hello/morpheus-board-pill/README.md

morpheus-board-pill
===================

sleep motion senser

Altium source for schematic / layout
