hello/morpheus-board-pill/pill.pvt/Morpheus_pill_MP_release_011215.PDF

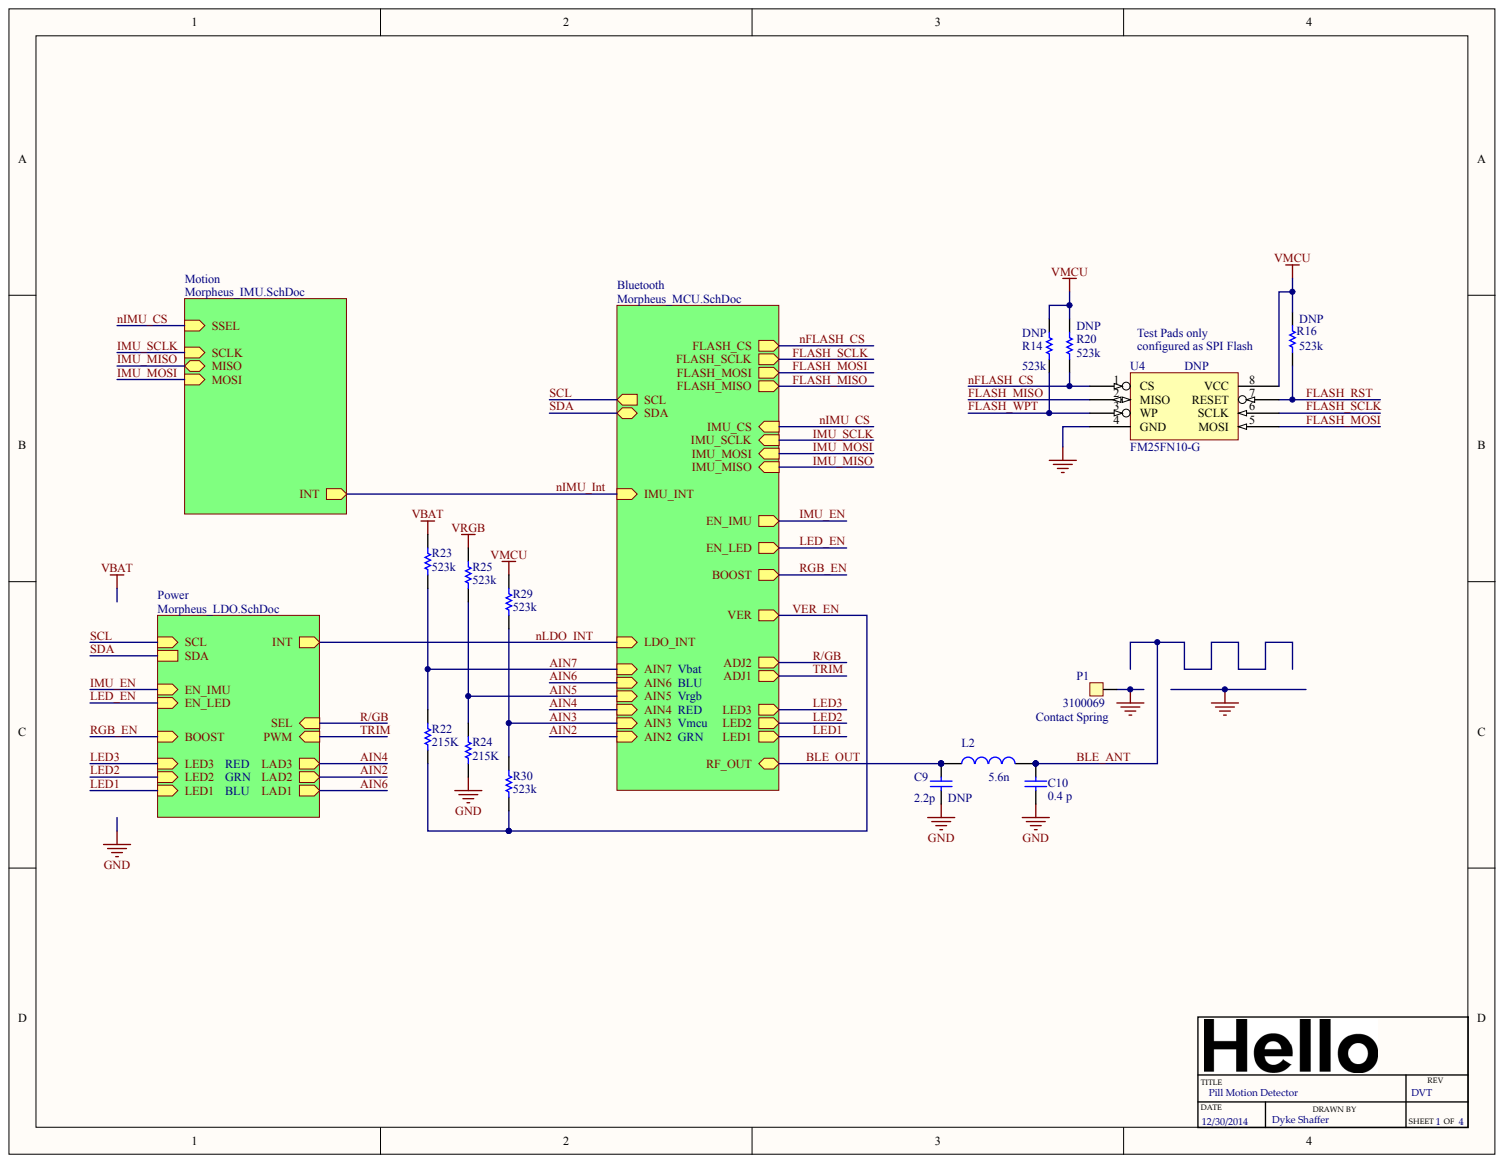
[picture p1: page 1]

configured as SPI Flash

AIN7

215K | | AIN6 AIN5

R24 | AIN4 AIN3

TITLE Pill Motion Detector | REV DVT

D ATE | DRAWN BY Dyke Shaffer | S HEET 1 OF

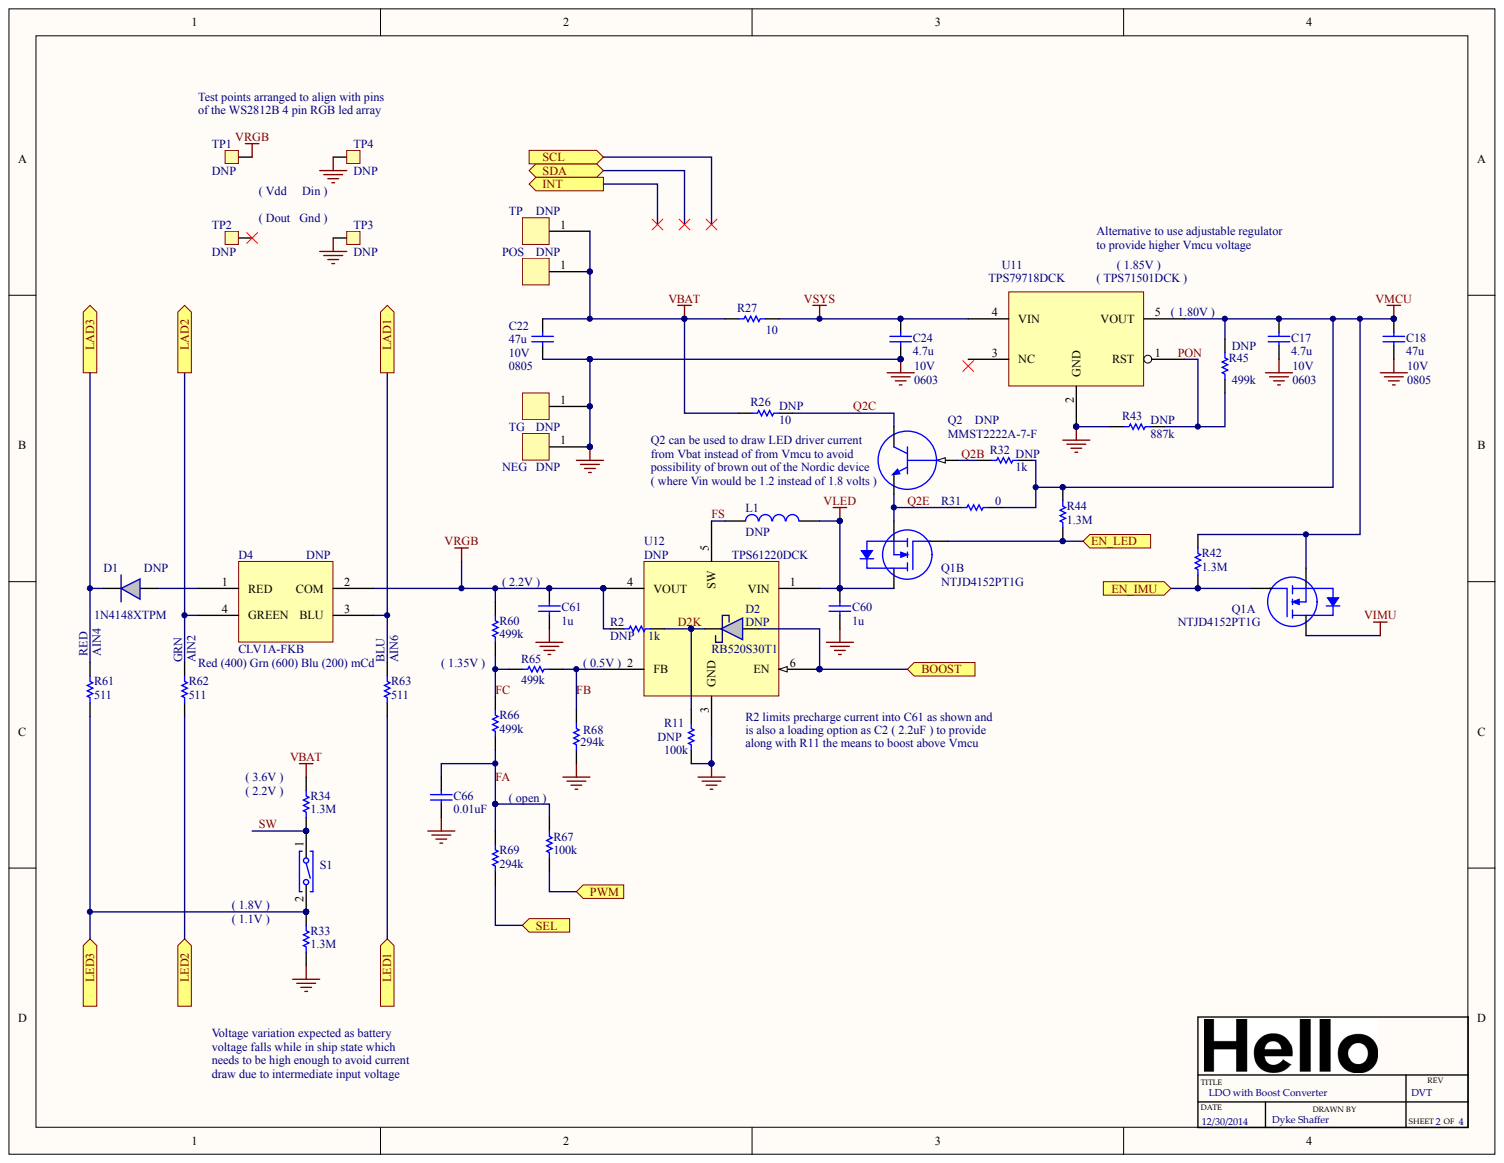
[picture p2: page 2]

Test points arranged to align with pins
of the WS2812B 4 pin RGB led array

Alternative to use adjustable regulator
to provide higher Vmcu voltage

VOUT RST | 1 NC

VIN

Q2 can be used to draw LED driver current
from Vbat instead of from Vmcu to avoid
possibility of brown out of the Nordic device
( where

Vin would be 1.2 instead of 1.8 volts )

R2 limits precharge current into C61 as shown and
is also a loading option as C2 ( 2.2uF ) to provide
along with R11 the means to boost above Vmcu

Voltage variation expected as battery
voltage falls while in ship state which
needs to be high enough to avoid current
draw due to intermediate input voltage

LDO with Boost Con verter

D ATE | DRAWN BY Dyke Shaffer | S HEET 2 OF

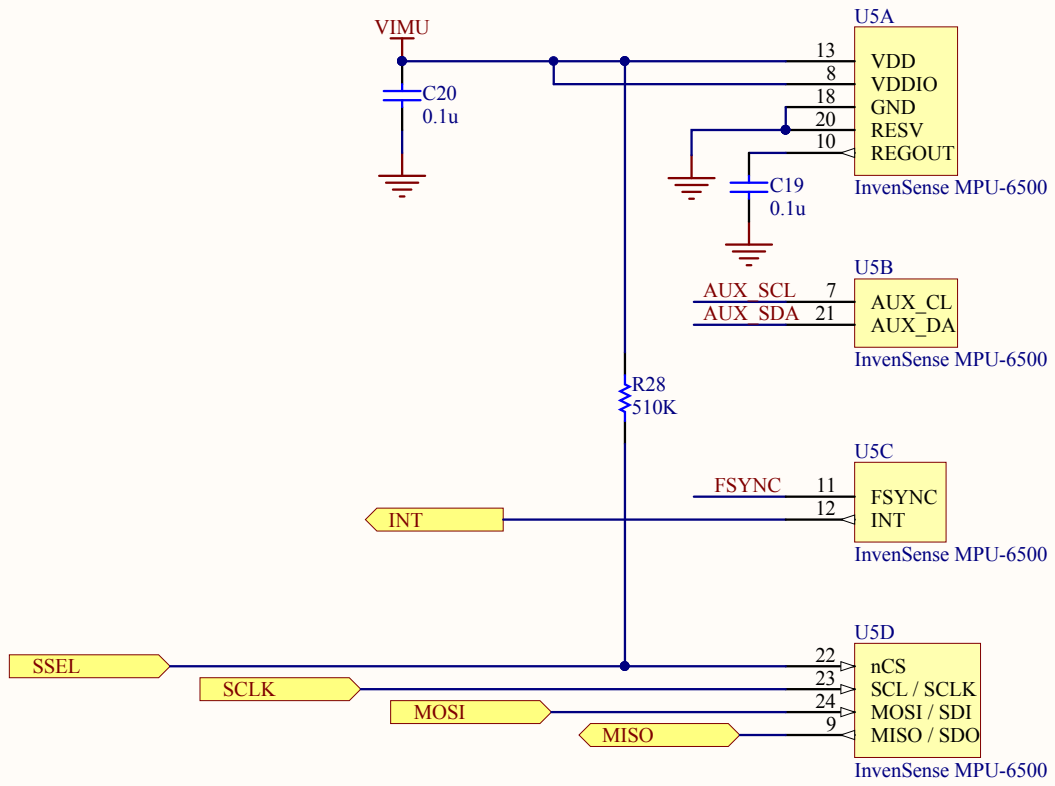
[picture p3: page 3]

IMU Motion Detecter

DATE | DRAWN BY * | SHEET 3 OF 4

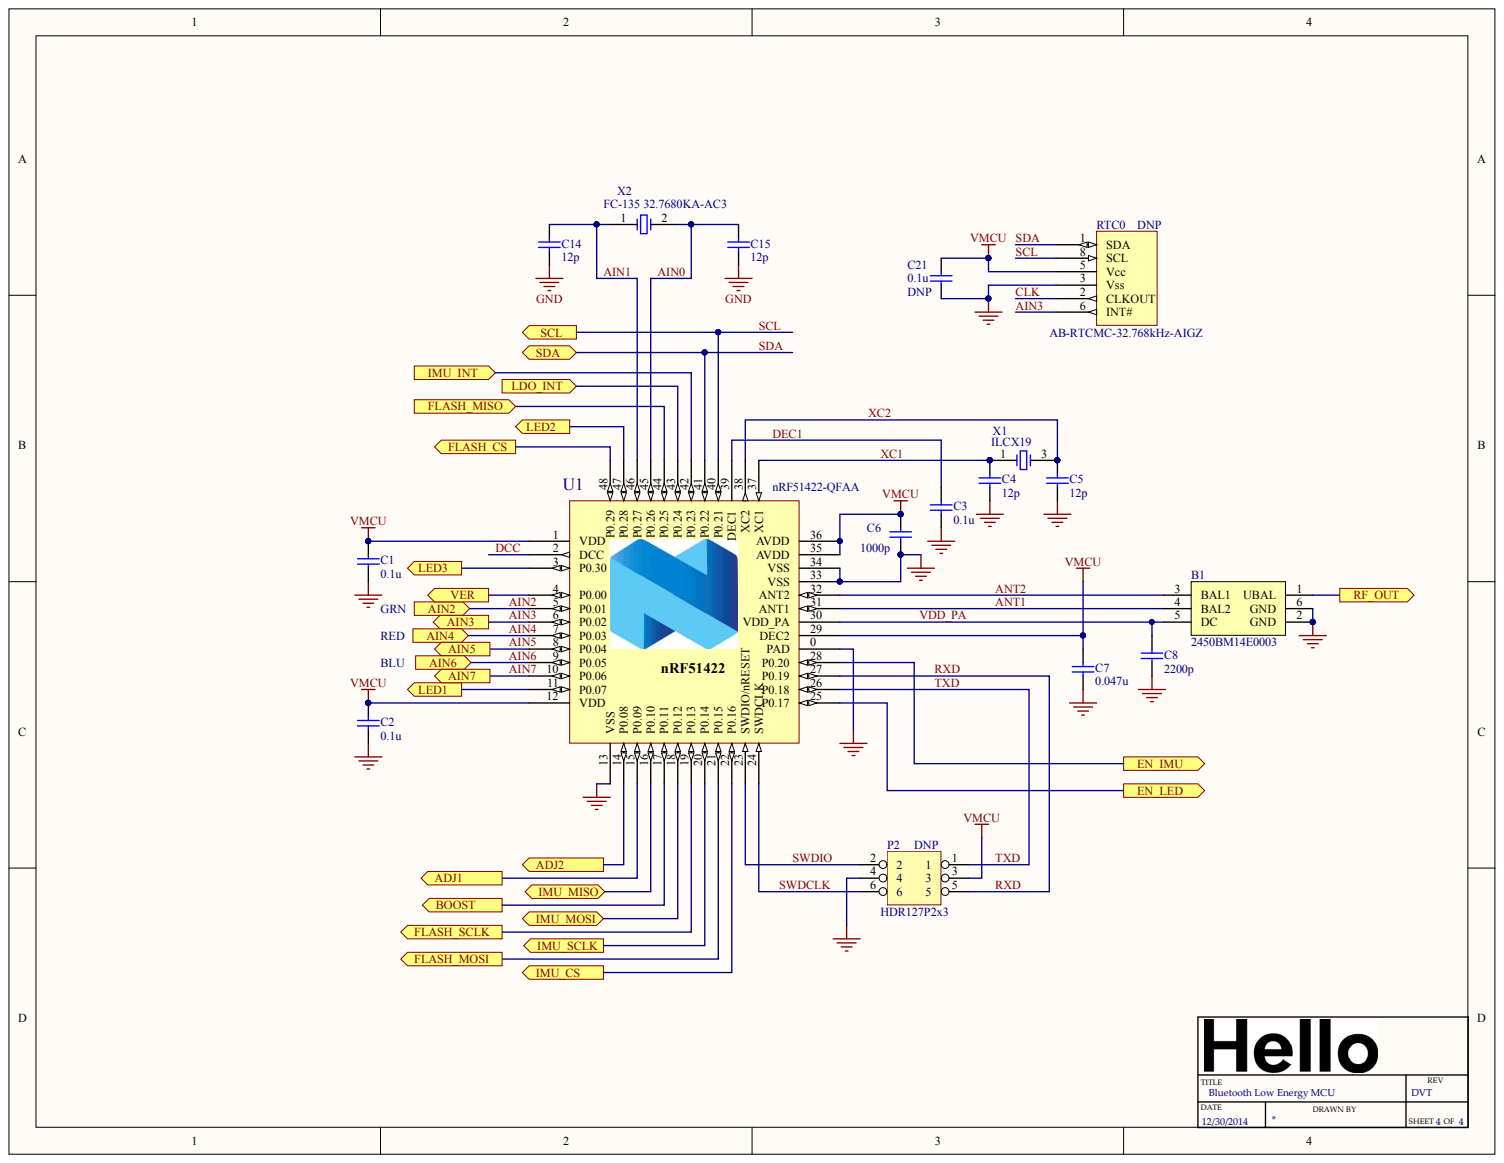
[picture p4: page 4]

VMCU

ADJ2 | | | | SWDIO

SWDCLK | 4 4 5 | 5 3 3 | RXD

Bluetooth Low Energy MCU

DATE | DRAWN BY * | SHEET 4 OF 4

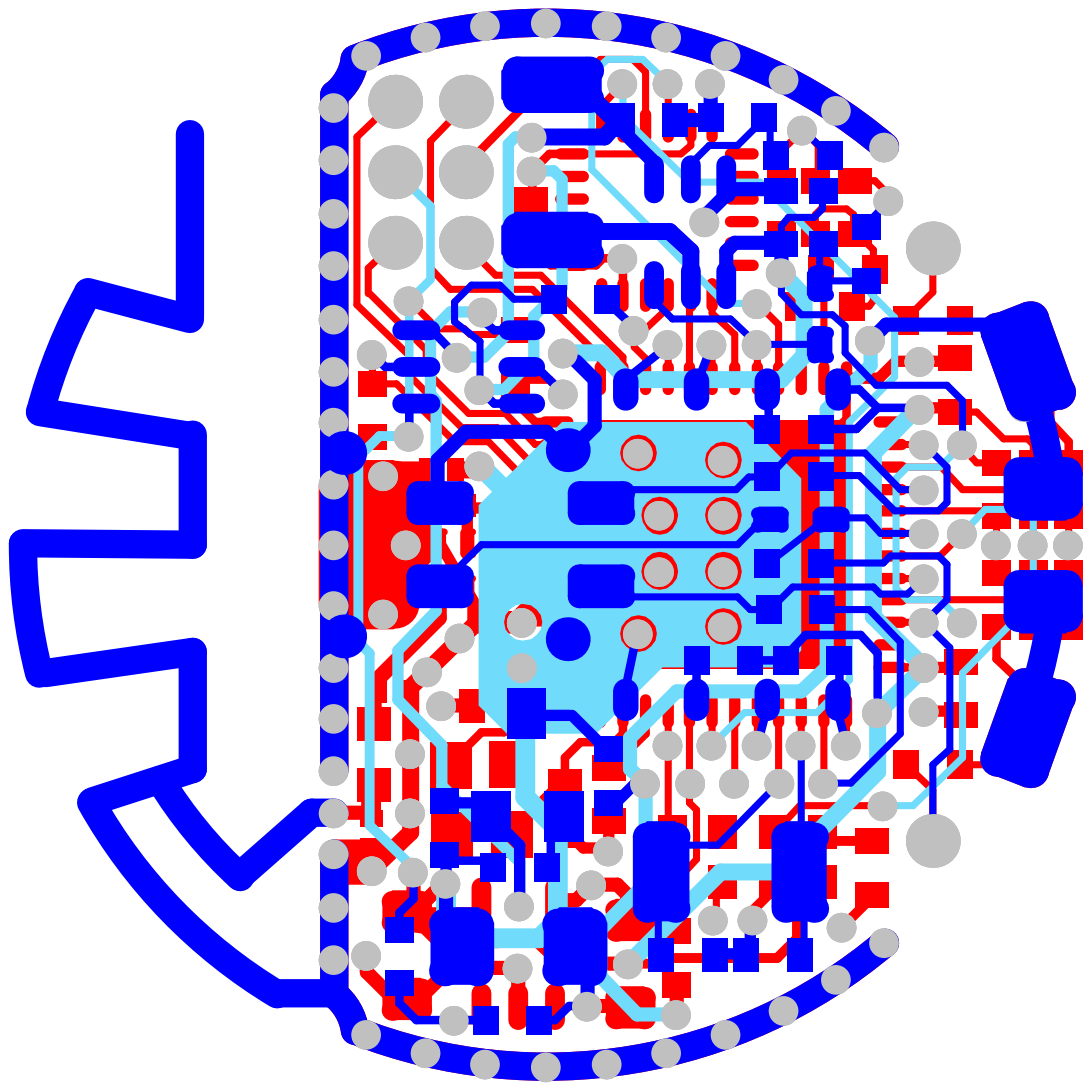
[picture p5: page 5]
