hello/morpheus-board-pill/Release Files/Morpheus_pill_MP_release_011215.PDF

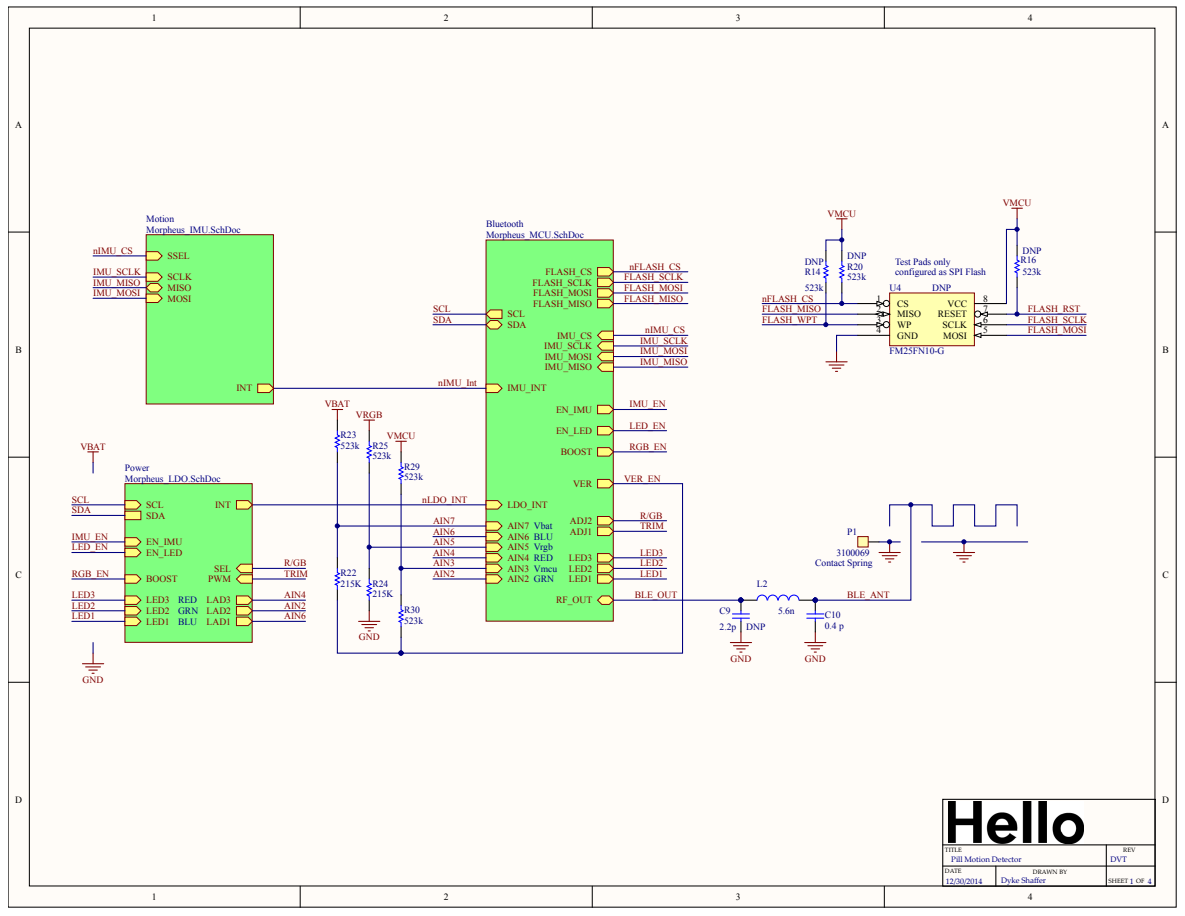
[picture p6: page 1]

AIN7

215K R24 | AIN6 AIN5

AIN4 AIN3

TITLE Pill Motion Detector | REV DVT

DaTE | DRaWN BY Dyke Shaffer | SHEET 1 OF 4

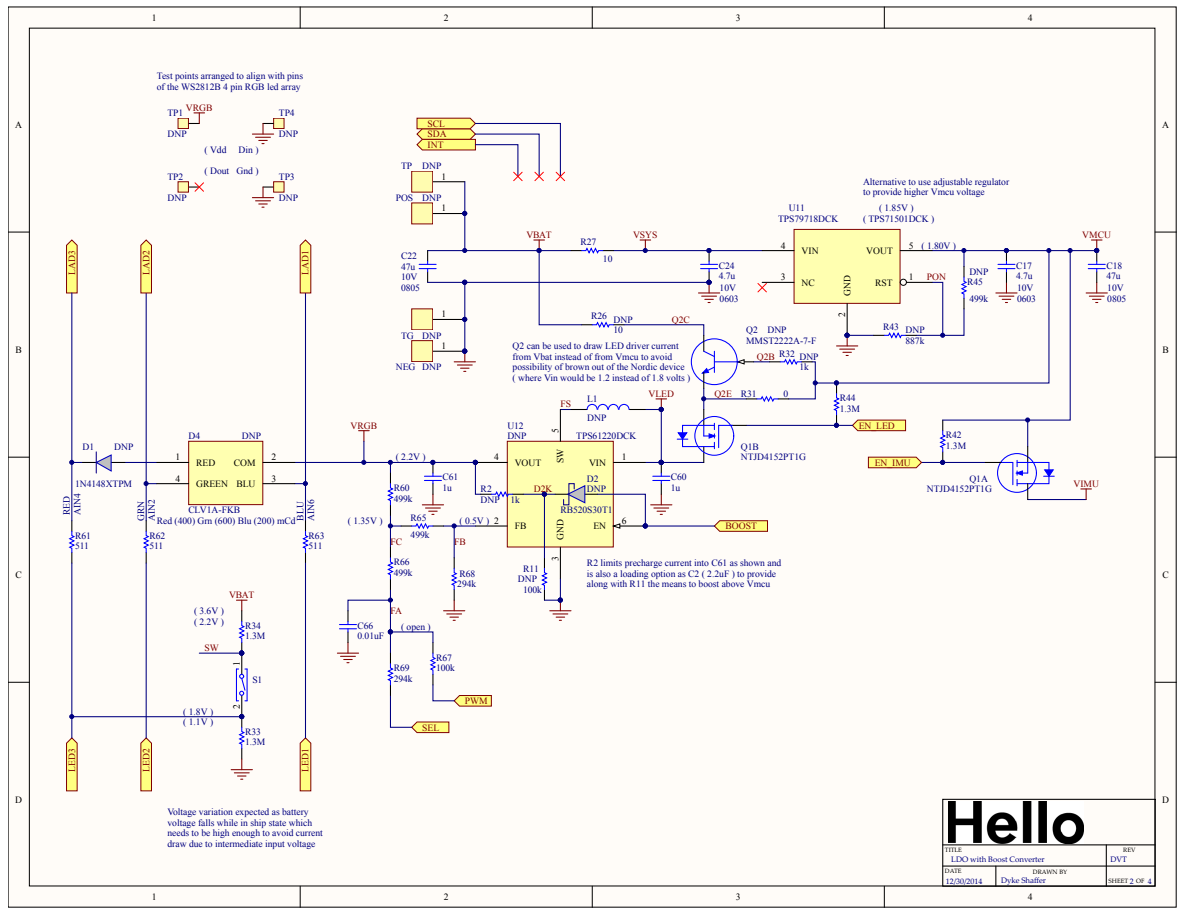
[picture p7: page 2]

Test points arranged to align with pins
of the WS2812B 4 pin RGB led array

Alternative to use adjustable regulator
to provide higher Vmcu voltage

VIN 4

RST | 1 NC 3

Q2 can be used to draw LED driver current
from Vbat instead of from Vmcu to avoid
possibility of brown out of the Nordic device
( where Vin would be 1.2 instead of 1.8 volts )

R2 limits precharge current into C61 as shown and
is also a loading option as C2 ( 2.2uF ) to provide
along with R11 the means to boost above Vmcu

Voltage variation expected as battery
voltage falls while in ship state which
needs to be high enough to avoid current
draw due to intermediate input voltage

LDO with Boost Converter

Dyke Shaffer

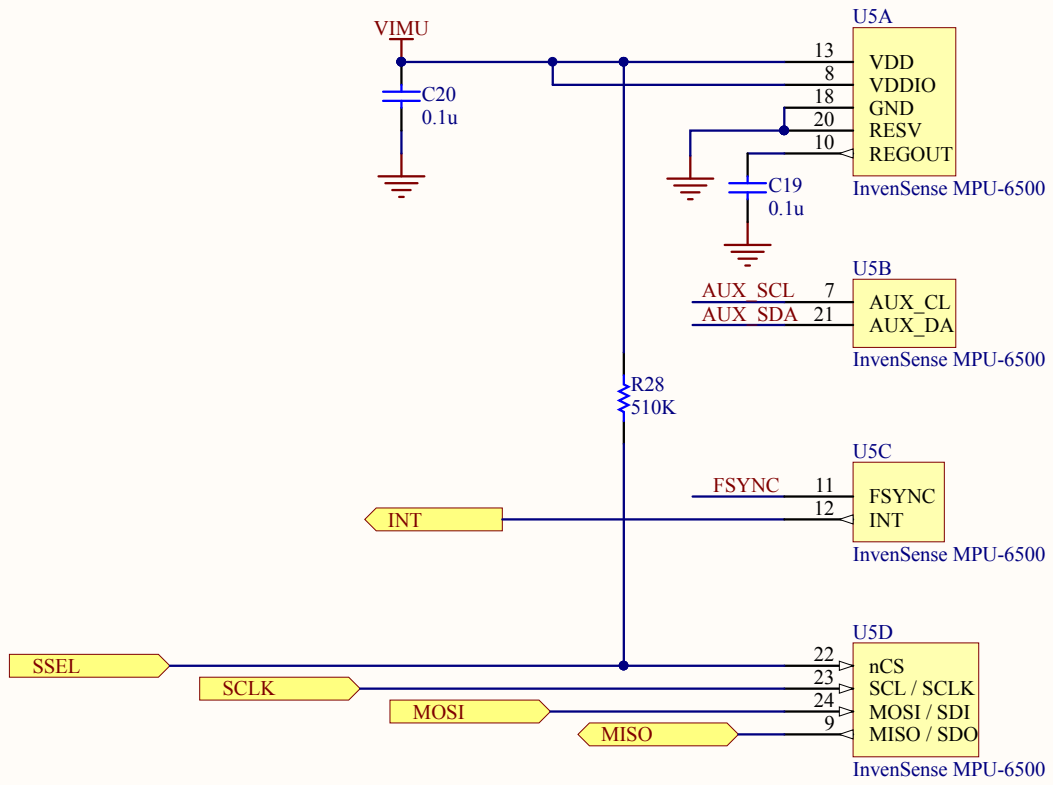
[picture p8: page 3]

IMU Motion Detecter

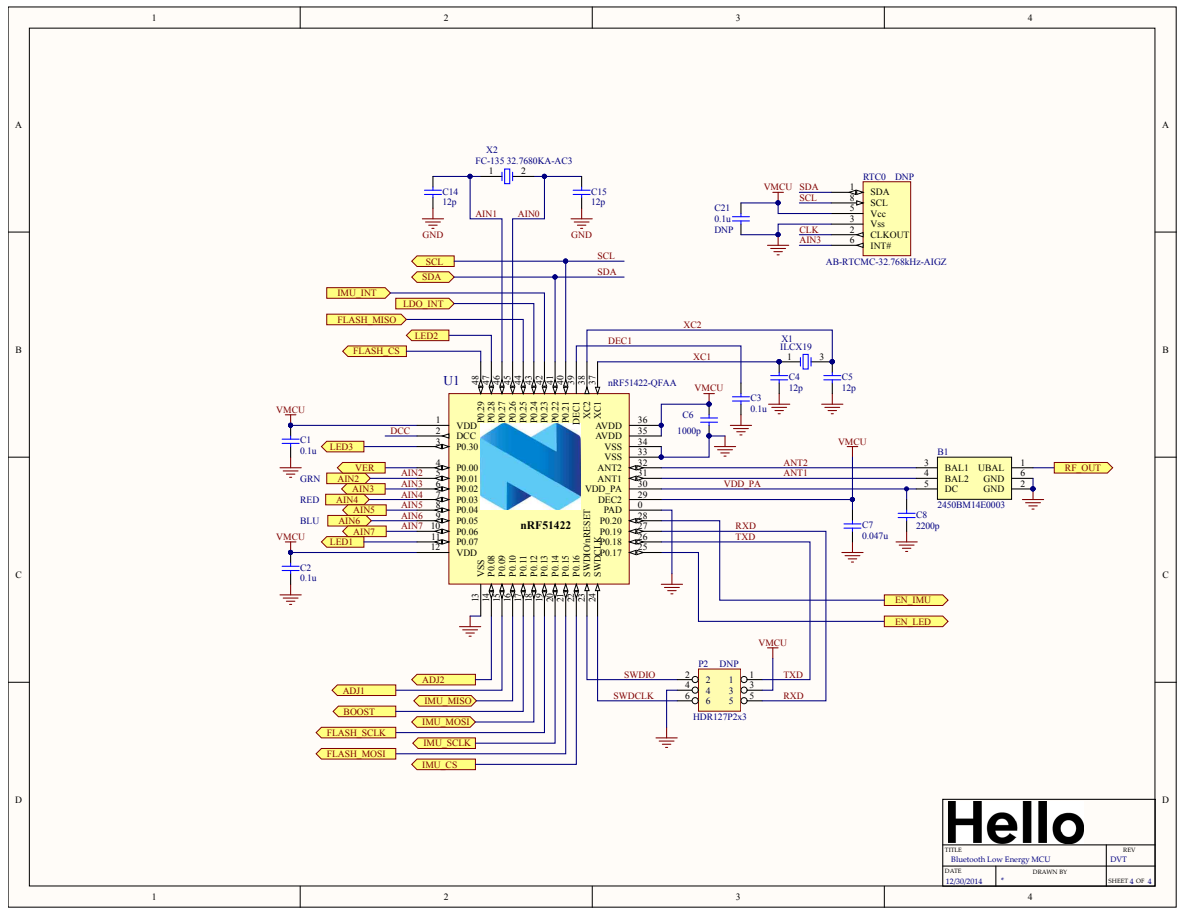
[picture p9: page 4]

VMCU

ADJ2 | | | | SWDIO

SWDCLK | 4 4 5 | 5 3 3 | RXD

IMU_MISO | 6 6

Bluetooth Low Energy MCU

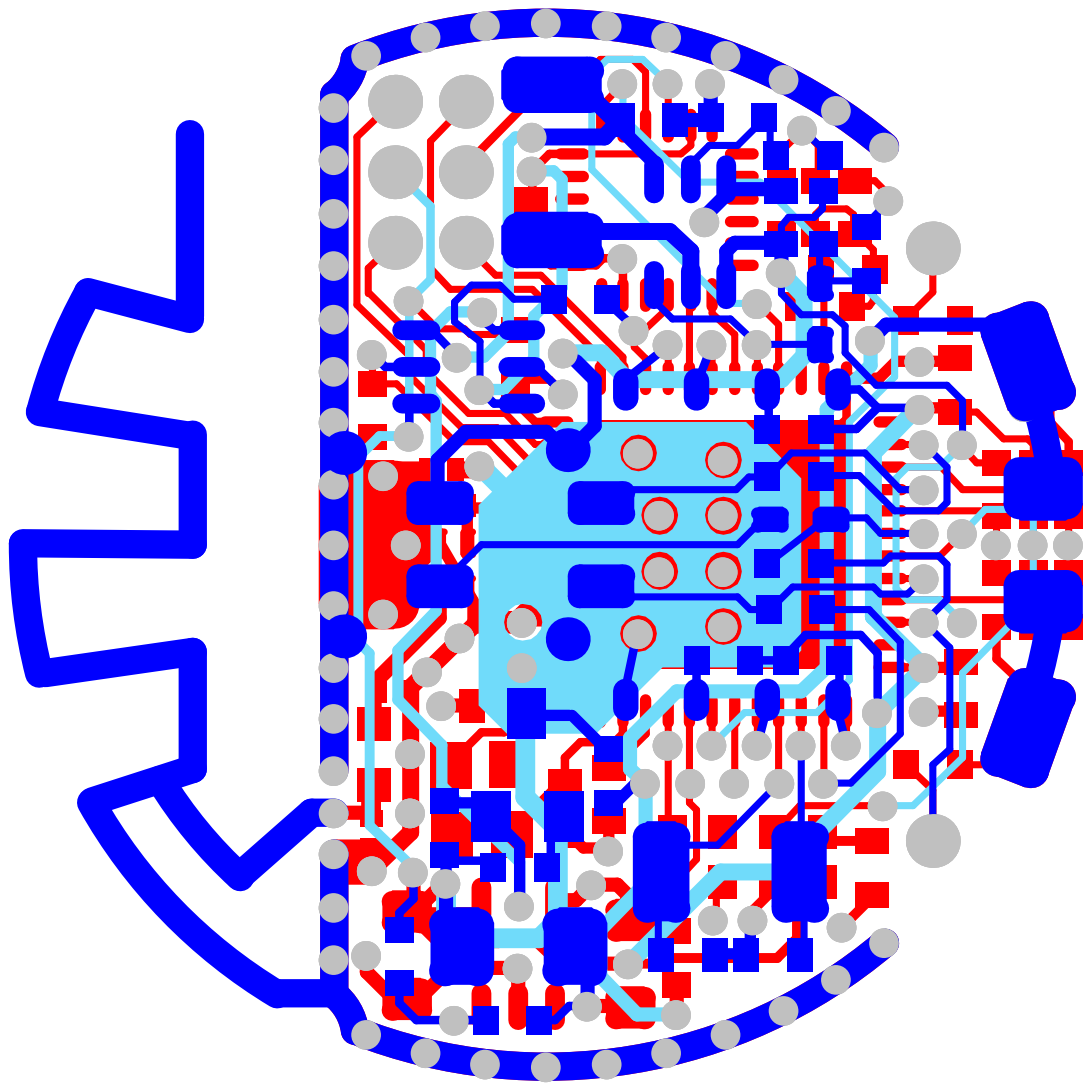
[picture p10: page 5]
