hello/morpheus-board-pill/(list of files, drawings)

Other design files:
pill.pvt/Morpheus_IMU.SchDoc
pill.pvt/Morpheus_LDO.SchDoc
pill.pvt/Morpheus_MCU.SchDoc
pill.pvt/Morpheus_pill.PcbDoc
pill.pvt/Morpheus_pill.PrjPcb
pill.pvt/Morpheus_pill.SchDoc
