hello/morpheus-board-pill/(commit log)

2014-09-03 initial commit of pill board altium source
    Morpheus_pill.PrjPcb Project Organization
    Morpheus_pill.PcbDoc Board Layout
    Morpheus_pill.SchDoc Top Level Schematic
    Morpheus_IMU.SchDoc Motion Sensor
    Morpheus_LDO.SchDoc Power Conversion for MCU and LED
    Morpheus_MEM.SchDoc FRAM Memory
    Morpheus_MCU.SchDoc Nordic BlueTooth
    [Morpheus_IMU.SchDoc, Morpheus_LDO.SchDoc, Morpheus_MCU.SchDoc, Morpheus_MEM.SchDoc, Morpheus_pill.PcbDoc, Morpheus_pill.PrjPcb, Morpheus_pill.SchDoc]
2014-09-15 Pill EVT2
    [Morpheus_IMU.SchDoc, Morpheus_LDO.SchDoc, Morpheus_MCU.SchDoc, Morpheus_MEM.SchDoc, Morpheus_pill.PcbDoc, Morpheus_pill.PrjPcb, Morpheus_pill.SchDoc]
2014-11-19 updated schematic and layout to align with the 11/20/14 build of 100 EVT2 units with ECO rework to add schottky diode
    [Morpheus_LDO.SchDoc, Morpheus_MCU.SchDoc, Morpheus_MEM.SchDoc, Morpheus_pill.PcbDoc, Morpheus_pill.PrjPcb, Morpheus_pill.SchDoc, Morpheus_pill.xlsx, Morpheus_pill_EVT2_111814.xlsx]
2014-11-28 initial DVT release (prior to DFM feedback from CM)
    [Morpheus_IMU.SchDoc, Morpheus_LDO.SchDoc, Morpheus_MCU.SchDoc, Morpheus_MEM.SchDoc, Morpheus_pill.PcbDoc, Morpheus_pill.PrjPcb, Morpheus_pill.SchDoc, Morpheus_pill.xlsx]
2014-12-30 pill PVT release candidate
    [Morpheus_LDO.SchDoc, Morpheus_MCU.SchDoc, Morpheus_pill.PcbDoc, Morpheus_pill.PrjPcb, Morpheus_pill.SchDoc, Morpheus_pill_PVT_123014.xlsx]
2015-01-10 PVT Release 12/30/14
    PVT Release as sent to Jabil 12/30/14 for PVT/MP build. Minor tweaks
    from Dyke’s commit.
    - update Drill Drawing annotation (From DVT EQs)
    - add D4 silkscreen outline and pin 1 identification (Improve MFG Yield)
    - update part number 905-00007-5 (Update to match revised PNs)
    - update date code (C) 2014 <logo> Hello Inc (Update for Production)
    - change value / part number for C10 ( 0.4pF ) (From ECO20141215-0002)
    - change value / part number for L2 ( 5.6uH ) (From ECO20141215-0002)
    - remove D3 ( LiteOn RGB Led ) from schematic / layout (Loading option)
    - no load ( DNP ) active components in led driver (Removal of Feature)
    - no load (DNP) D4 (Removal of Featur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
    [Morpheus_IMU.SchDoc, Morpheus_LDO.SchDoc, Morpheus_MCU.SchDoc, Morpheus_pill.PcbDoc, Morpheus_pill.PrjPcb, Morpheus_pill.SchDoc, Morpheus_pill_EVT2_111814.xlsx]
2015-06-30 Mass production (1/15)
    [Morpheus_IMU.SchDoc, Morpheus_LDO.SchDoc, Morpheus_MCU.SchDoc, Morpheus_pill.PcbDoc, Morpheus_pill.PrjPcb, Morpheus_pill.SchDoc, Morpheus_pill_DVT_112614.xlsx, Morpheus_pill_PVT_123014.xlsx]
2015-06-30 Cost reduction version for NPI build
    [Morpheus_IMU.SchDoc, Morpheus_LDO.SchDoc, Morpheus_MCU.SchDoc, Morpheus_pill.PrjPcb, Morpheus_pill.SchDoc]
